sarahanderson99/Senior-Design-1---Automonous-Puzzle-Solver/Project 2/gameboard_test.png

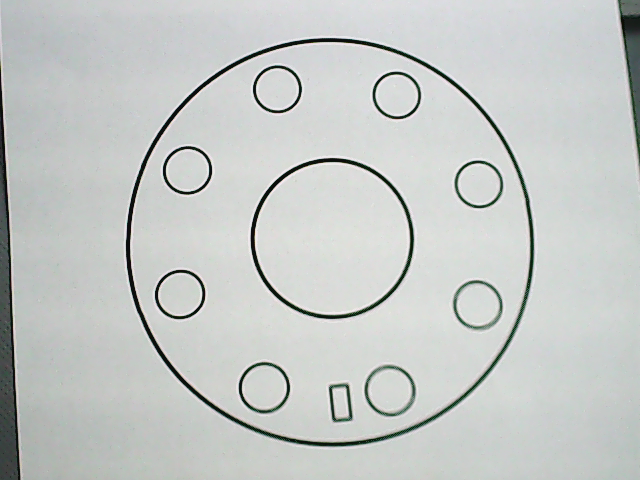
Project 2/gameboard_test.png
