sarahanderson99/Senior-Design-1---Automonous-Puzzle-Solver/Project 2/report2_graded_rubric_p1.PNG

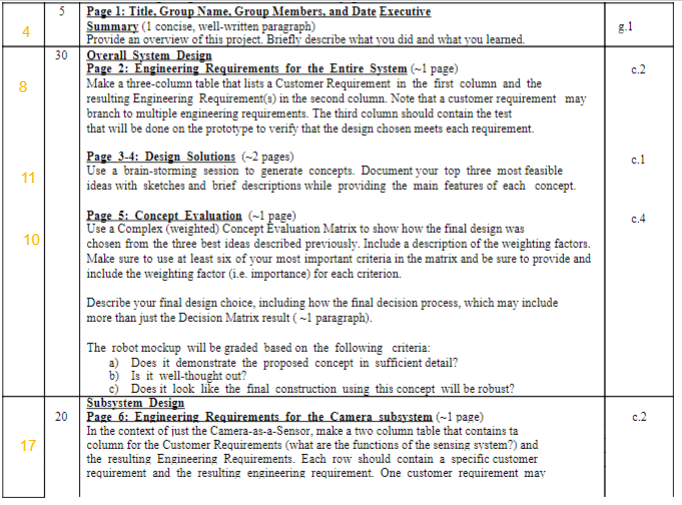
Project 2/report2_graded_rubric_p1.PNG
