sarahanderson99/Senior-Design-1---Automonous-Puzzle-Solver/Project 1/graded_project1_rubric.PNG

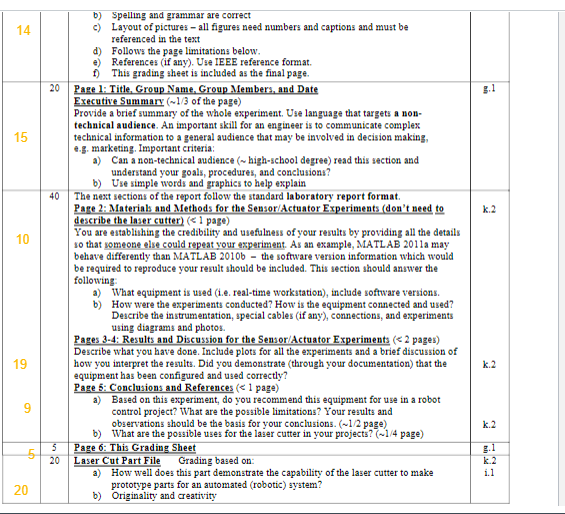
Project 1/graded_project1_rubric.PNG
