sarahanderson99/Senior-Design-1---Automonous-Puzzle-Solver/Project 2/new_gameboard.png

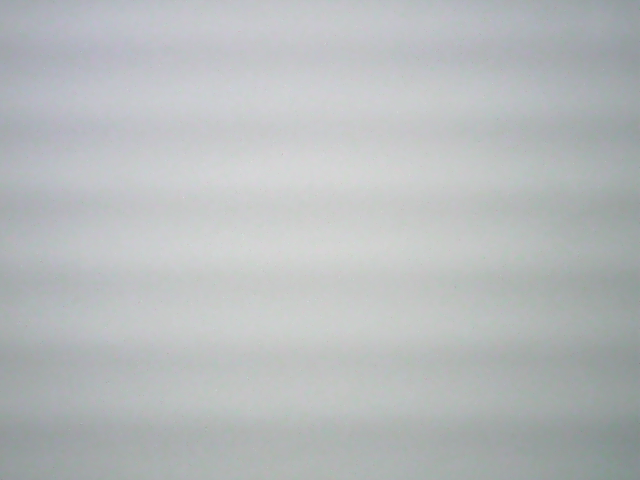
Project 2/new_gameboard.png
