sarahanderson99/Senior-Design-1---Automonous-Puzzle-Solver/Project 2/new_markers_rocky.png

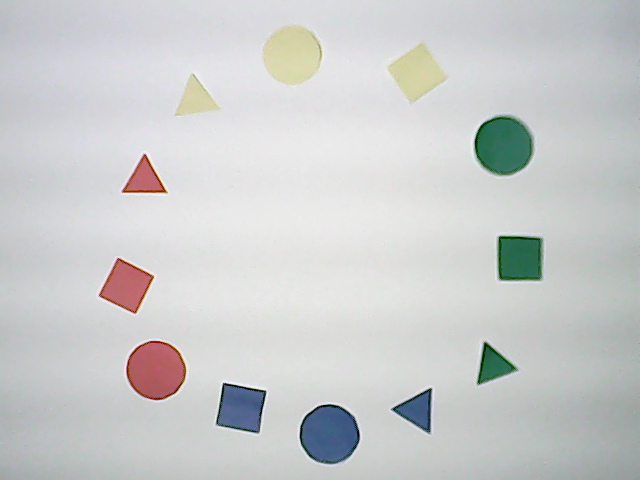
Project 2/new_markers_rocky.png
