sarahanderson99/Senior-Design-1---Automonous-Puzzle-Solver/Project 2/report2_graded_rubric_p2.PNG

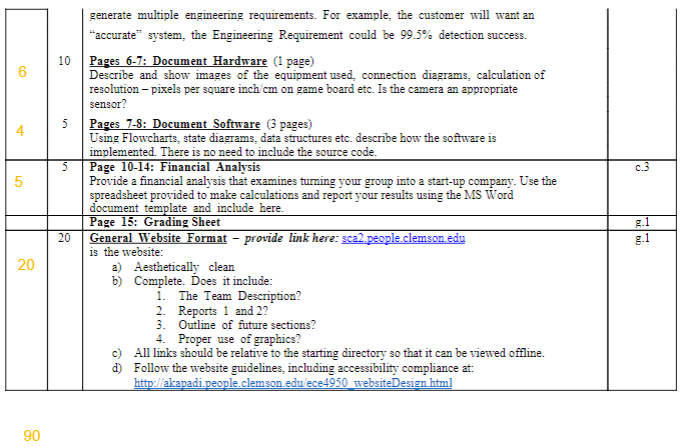
Project 2/report2_graded_rubric_p2.PNG
