sarahanderson99/Senior-Design-1---Automonous-Puzzle-Solver/(list of files, cad)

Other CAD files:
Project 1/Laser Cutter Group 13 Resized.dwg
